Madjogger1202/PCIe-to-Ethernet_x1/PCIe-to-Ethernet_x1/PCIe-to-Ethernet_x1.kicad_pcb

## KiCad design PCIe-to-Ethernet_x1/PCIe-to-Ethernet_x1.kicad_pcb (2025-03-23)

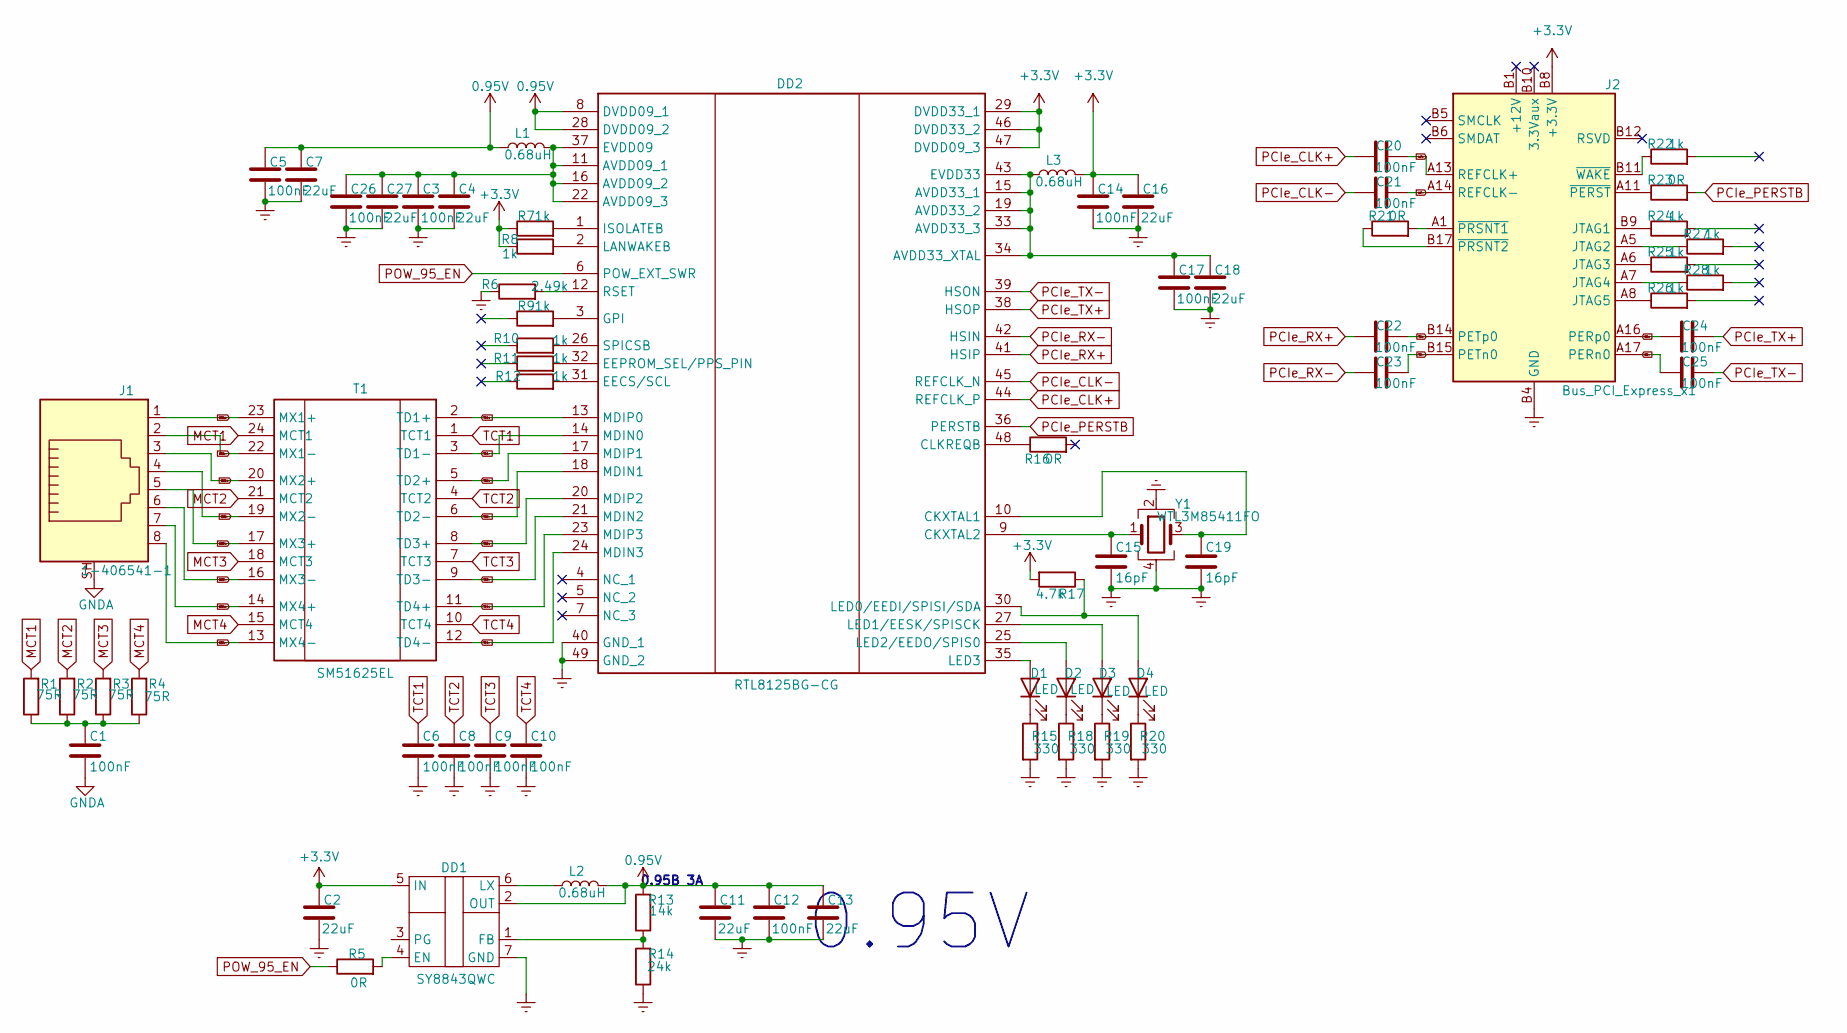
[picture p1: schematic PCIe-to-Ethernet_x1.kicad_sch]

Parts:
C1, C3, C5, C6, C8, C9, C10, C12, C14, C17, C20, C21, C22, C23, C24, C25, C26: 100nF; C_0402_1005Metric
C2, C4, C7, C11, C13, C16, C18, C27: 22uF; C_0402_1005Metric
C15, C19: 16pF; C_0402_1005Metric
D1, D2, D3, D4: LED; LED_0402_1005Metric
DD1: SY8843QWC
DD2: RTL8125BG-CG; QFN40P600X600X100-49N; Manufacturer_Part_Number RTL8125BG-CG
J1: 1-406541-1; RJ45_Amphenol_RJHSE5380
J2: Bus_PCI_Express_x1; BUS_PCIexpress_x1
L1, L2, L3: 0.68uH; L_Cenker_CKCS4020
R1, R2, R3, R4: 75R; R_0402_1005Metric
R5, R16, R21, R23: 0R; R_0402_1005Metric
R6: 2.49k; R_0402_1005Metric
R7, R8, R9, R10, R11, R12, R22, R24, R25, R26, R27, R28: 1k; R_0402_1005Metric
R13: 14k; R_0402_1005Metric
R14: 24k; R_0402_1005Metric
R15, R18, R19, R20: 330; R_0402_1005Metric
R17: 4.7k; R_0402_1005Metric
T1: SM51625EL; SOIC127P1600X625-24N; Manufacturer_Part_Number SM51625EL; Mouser Part Number 652-SM51625EL
Y1: WTL3M85411FO; Crystal_SMD_3225-4Pin_3.2x2.5mm

Connections:
0.95V: C5.1, C7.1, C11.1, C12.1, C13.1, DD1.2 (OUT), DD2.8 (DVDD09_1), DD2.28 (DVDD09_2), L1.1, L2.2, R13.2
+3.3V: C2.1, C14.1, C16.1, DD1.5 (IN), DD2.29 (DVDD33_1), DD2.46 (DVDD33_2), DD2.47 (DVDD09_3), J2.A9 (+3.3V), J2.A10 (+3.3V), J2.B8 (+3.3V), L3.2, R7.1, R8.1, R17.2
Earth: C2.2, C3.2, C4.2, C5.2, C6.2, C7.2, C8.2, C9.2, C10.2, C11.2, C12.2, C13.2, C14.2, C15.2, C16.2, C17.2, C18.2, C19.2, C26.2, C27.2, DD1.7 (GND), DD2.40 (GND_1), DD2.49 (GND_2), J2.A4 (GND), J2.A12 (GND), J2.A15 (GND), J2.A18 (GND), J2.B4 (GND), J2.B7 (GND), J2.B13 (GND), J2.B16 (GND), J2.B18 (GND), R6.1, R14.1, R15.2, R18.2, R19.2, R20.2, Y1.2, Y1.4
GNDA: C1.2, J1.SH
MCT1: R1.2, T1.24 (MCT1)
MCT2: R2.2, T1.21 (MCT2)
MCT3: R3.2, T1.18 (MCT3)
MCT4: R4.2, T1.15 (MCT4)
MX1+: J1.1, T1.23 (MX1+)
MX1-: J1.2, T1.22 (MX1-)
MX2+: J1.3, T1.20 (MX2+)
MX2-: J1.4, T1.19 (MX2-)
MX3+: J1.5, T1.17 (MX3+)
MX3-: J1.6, T1.16 (MX3-)
MX4+: J1.7, T1.14 (MX4+)
MX4-: J1.8, T1.13 (MX4-)
unnamed: C1.1, R1.1, R2.1, R3.1, R4.1
unnamed: D1.2 (A), DD2.35 (LED3)
unnamed: D1.1 (K), R15.1
unnamed: D2.2 (A), DD2.25 (LED2/EEDO/SPIS0)
unnamed: D2.1 (K), R18.1
unnamed: D3.2 (A), DD2.27 (LED1/EESK/SPISCK)
unnamed: D3.1 (K), R19.1
unnamed: D4.2 (A), DD2.30 (LED0/EEDI/SPISI/SDA), R17.1
unnamed: D4.1 (K), R20.1
unnamed: DD1.4 (EN), R5.2
unnamed: DD1.1 (FB), R13.1, R14.2
unnamed: DD1.6 (LX), L2.1
unnamed: C3.1, C4.1, C26.1, C27.1, DD2.11 (AVDD09_1), DD2.16 (AVDD09_2), DD2.22 (AVDD09_3), DD2.37 (EVDD09), L1.2
unnamed: C17.1, C18.1, DD2.15 (AVDD33_1), DD2.19 (AVDD33_2), DD2.33 (AVDD33_3), DD2.34 (AVDD33_XTAL), DD2.43 (EVDD33), L3.1
unnamed: C19.1, DD2.10 (CKXTAL1), Y1.3
unnamed: C15.1, DD2.9 (CKXTAL2), Y1.1
unnamed: DD2.48 (CLKREQB), R16.1
unnamed: DD2.31 (EECS/SCL), R12.2
unnamed: DD2.32 (EEPROM_SEL/PPS_PIN), R11.2
unnamed: DD2.3 (GPI), R9.2
unnamed: DD2.1 (ISOLATEB), R7.2
unnamed: DD2.2 (LANWAKEB), R8.2
unnamed: DD2.12 (RSET), R6.2
unnamed: DD2.26 (SPICSB), R10.2
unnamed: J2.B9 (JTAG1), R24.1
unnamed: J2.A5 (JTAG2), R27.1
unnamed: J2.A6 (JTAG3), R25.1
unnamed: J2.A7 (JTAG4), R28.1
unnamed: J2.A8 (JTAG5), R26.1
unnamed: J2.A11 (~PERST), R23.1
unnamed: J2.A1 (~PRSNT1), R21.2
unnamed: J2.B17 (~PRSNT2), R21.1
unnamed: J2.B11 (~WAKE), R22.1
PCIe_CLK+: C20.1, DD2.44 (REFCLK_P)
PCIe_CLK-: C21.1, DD2.45 (REFCLK_N)
PCIe_PERSTB: DD2.36 (PERSTB), R23.2
PCIe_RX+: C22.1, DD2.41 (HSIP)
PCIe_RX-: C23.1, DD2.42 (HSIN)
PCIe_TX+: C24.2, DD2.38 (HSOP)
PCIe_TX-: C25.2, DD2.39 (HSON)
POW_95_EN: DD2.6 (POW_EXT_SWR), R5.1
RX+: C24.1, J2.A16 (PERp0)
RX-: C25.1, J2.A17 (PERn0)
TCT1: C6.1, T1.1 (TCT1)
TCT2: C8.1, T1.4 (TCT2)
TCT3: C9.1, T1.7 (TCT3)
TCT4: C10.1, T1.10 (TCT4)
TD1+: DD2.13 (MDIP0), T1.2 (TD1+)
TD1-: DD2.14 (MDIN0), T1.3 (TD1-)
TD2+: DD2.17 (MDIP1), T1.5 (TD2+)
TD2-: DD2.18 (MDIN1), T1.6 (TD2-)
TD3+: DD2.20 (MDIP2), T1.8 (TD3+)
TD3-: DD2.21 (MDIN2), T1.9 (TD3-)
TD4+: DD2.23 (MDIP3), T1.11 (TD4+)
TD4-: DD2.24 (MDIN3), T1.12 (TD4-)
TX+: C22.2, J2.B14 (PETp0)
TX-: C23.2, J2.B15 (PETn0)
ref+: C20.2, J2.A13 (REFCLK+)
ref-: C21.2, J2.A14 (REFCLK-)

Notes on the sheet:
0.95В 3А
0.95V

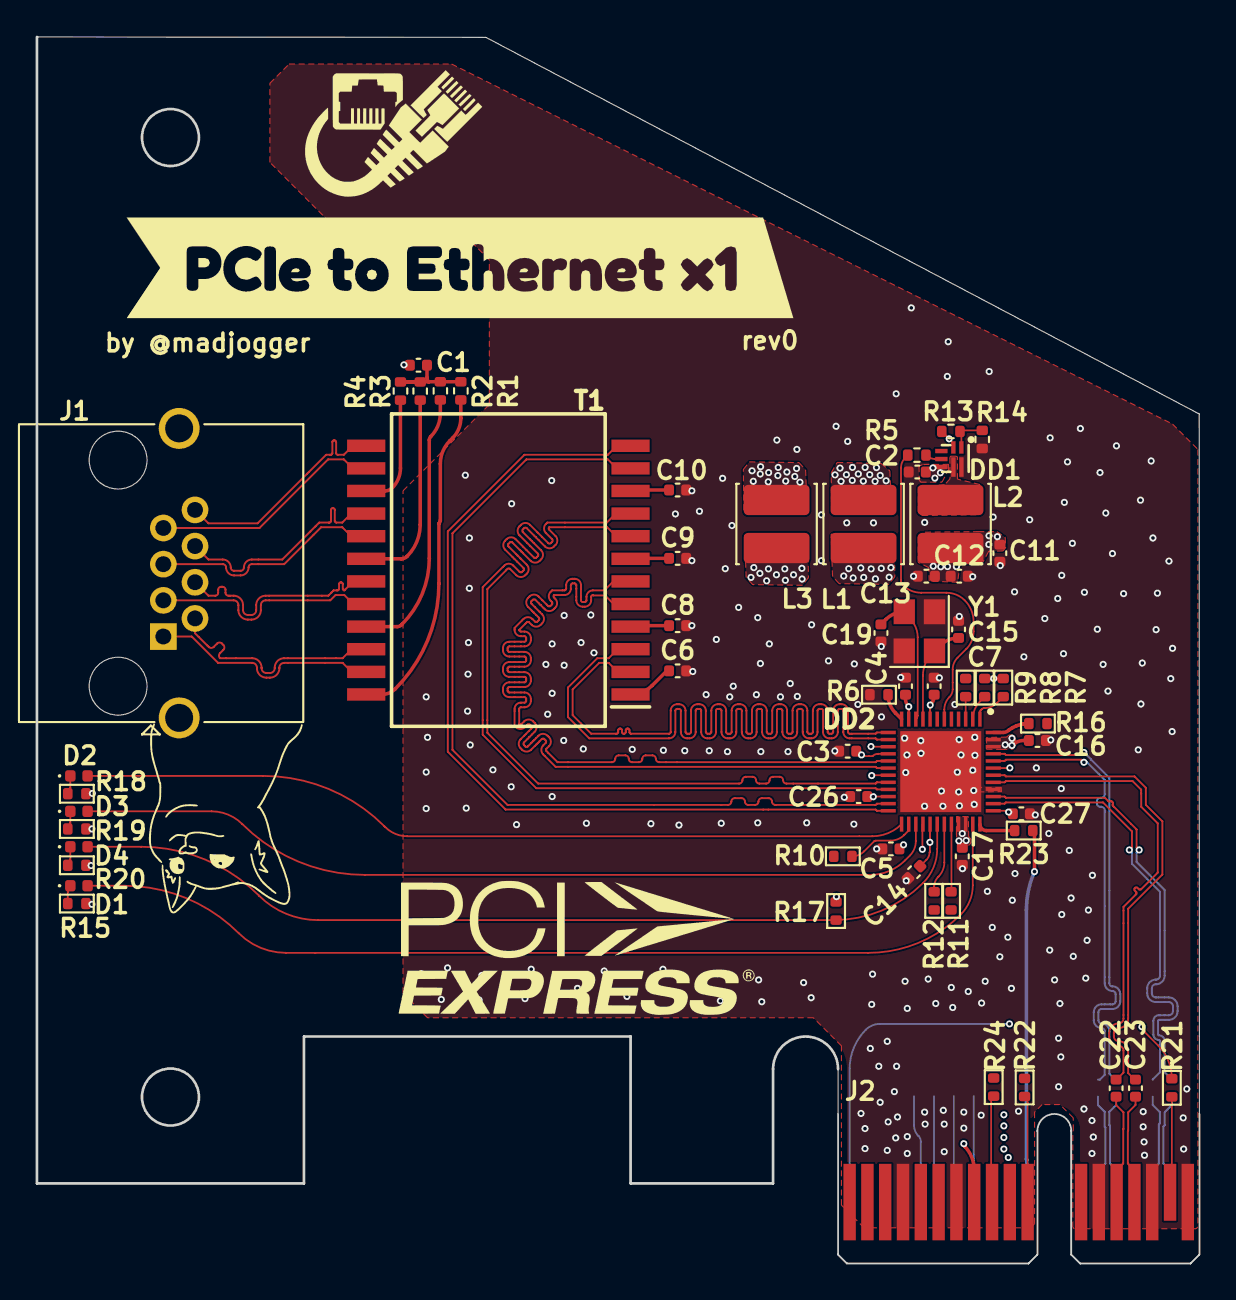
[picture p2: board PCIe-to-Ethernet_x1.kicad_pcb from above]

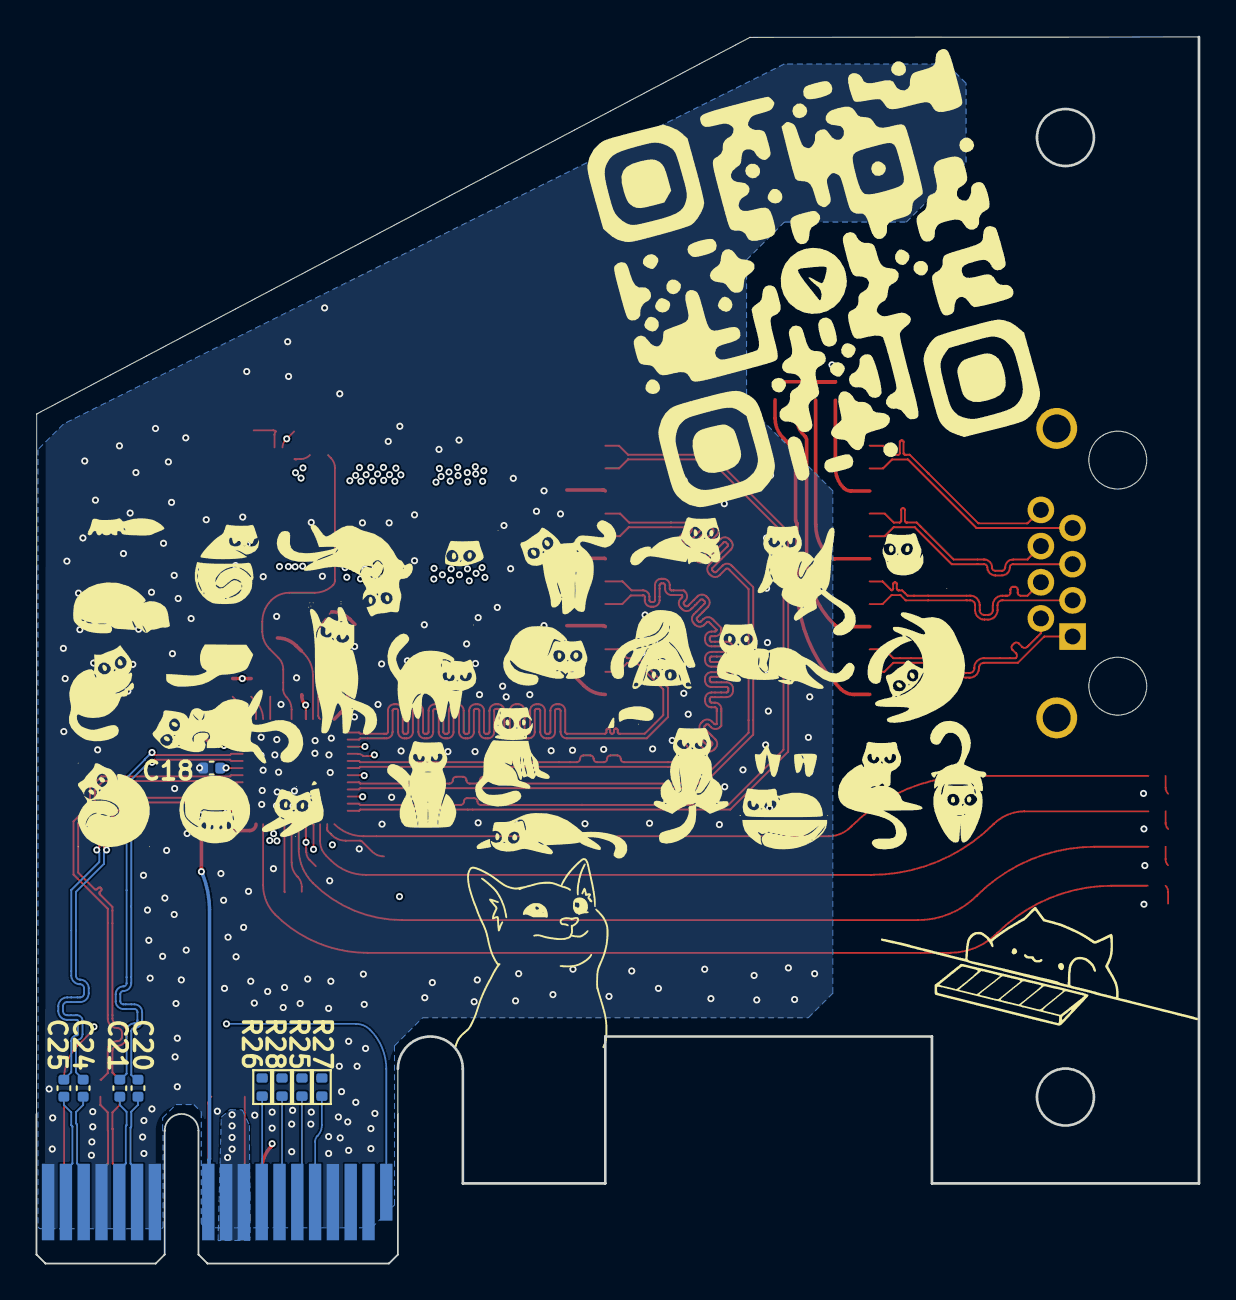
[picture p3: board PCIe-to-Ethernet_x1.kicad_pcb from below]

Board: 4 copper layers, 65.3 x 68.9 mm, 70 parts (9 on the bottom side), 75 nets.

Other parts of the board:
J1#2: PCIexpress_bracket; PCIexpress_bracket_low
kibuzzard-67DEDE50: G***; kibuzzard-67DEDE50
