Madjogger1202/PCIe-to-Ethernet_x1/(commit log)

2025-03-22 rev0 готова
    [PCIe-to-Ethernet_x1.kicad_pcb, PCIe-to-Ethernet_x1.kicad_sch]
2025-03-22 Чуть поправил землю чтобы можно было подпилить разъём PCIe ( для лучшего контакта )
    [PCIe-to-Ethernet_x1.kicad_pcb]
2025-03-23 Исправил отсутствие перекрёстного соединения на PCIe
    [PCIe-to-Ethernet_x1.kicad_pcb, PCIe-to-Ethernet_x1.kicad_sch]
